MuffinByteLabs/stm32-industrial-io/references/reference-designs/README.md

# Manufacturer guidance and reference designs

I use manufacturer reference designs to study implementation details, then verify them against my exact device, package, load, and board geometry. The original documents retain their manufacturer attribution.

## Retained local reference

I retained the [TI LMR38020 evaluation-module guide](REF_TI_LMR38020QEVM_UserGuide_SNVU817.pdf) for my buck-family study. Its values and layout are examples; I will recalculate and review the implementation for this board. Primary source: [TI SNVU817](https://www.ti.com/lit/ug/snvu817/snvu817.pdf).

I retained [TI SLVAF10: Driving PWM Loads with TI High-Side Switches](REF_TI_PWM_HighSide_SLVAF10.pdf) for DO3 timing, load and thermal review. I keep its [source/hash record](pwm_reference.json) alongside the PDF. Primary source: [TI SLVAF10](https://www.ti.com/lit/pdf/slvaf10). Its example-device values do not replace TPS4H160B timing or measured qualification of my selected load.

## Guidance to consult during capture

- [STM32G474VE product documentation](https://www.st.com/en/microcontrollers-microprocessors/stm32g474ve.html): exact package datasheet, reference manual, errata, and hardware-development guidance.
- [STM32 system-memory boot guidance, AN2606](https://www.st.com/resource/en/application_note/an2606-stm32microcontroller-system-memory-boot-mode-stmicroelectronics.pdf): verify recovery interfaces and entry requirements for the exact device.
- Candidate-family [local datasheet index](../datasheets/README.md): regulator layout, analog protection orientation/thresholds, isolated-power constraints, and peripheral timing.

Before adopting a reference circuit, I will record its revision, applicable ordering code, differences from my conditions, recalculated values, and schematic/layout evidence. I will add evaluated circuits and fixture records as they become available.

My [architecture](../../docs/Architecture.md) integrates the STM32 directly on the PCB.
