MuffinByteLabs/stm32-industrial-io/references/market/README.md

# Archived Upwork research — October 4, 2026

The [portfolio research report](Upwork_PCB_Portfolio_Review_2026-10-04.pdf) records the original comparison against seven user-supplied search-page exports. It predates the final retained scope and October 6 circuit corrections. The active decisions are in [market alignment](../../docs/Market_Alignment.md) and [scope](../../docs/Scope.md); the old report is evidence of that research, not current drawing instructions.

The [compressed evidence archive](upwork_evidence_2026-10-04.zip) preserves the original 350 parsed cards, 347 deduplicated briefs, final topic counts and matching excerpts, manual exclusions, inventory summary/methodology and the original parsing/tagging methods. It also retains the qualitative research notes. Archived methods use neutral `source_inputs/` directories for the supplied exports and are historical source material, separate from the project's active maintenance tools.

| Saved artifact | SHA-256 |
| --- | --- |
| Research PDF | `683830c0acd94d14554fa28573698611e4c220752bb3f29f6e1f670abf690463` |
| Evidence ZIP | `4523380ecafd39a0a9c29b8d5da04f3d05c1d06b42af976b48a2e073a8041826` |

All ten original archive members were compared byte-for-byte with the source files before temporary outputs were removed. For public sharing, local computer paths were replaced with neutral source IDs in two inventories and the parser; job text, counts and matching evidence are unchanged. The original archive remains preserved locally outside this repository. Generated page/contact previews, repeated CSV/tagged copies, PDF-extracted text and one-use report-building helpers were discarded. The evidence does not establish current job availability or a random sample of the employment market.
