MuffinByteLabs/stm32-industrial-io/references/reviews/README.md

# External-review evidence

I preserve the [submitted calculation script](independent_verification_calcs_2026-10-06.py) as source material, separate from active calculations. The [provenance record](external_review_2026-10-06.json) identifies the original file, hash, static inspection and the complete submitted report. The [original report](external_pre_capture_report_2026-10-05.txt) is a public text source with only its local workspace path neutralized; the original is preserved locally outside the repository; its historical Markdown links assume placement elsewhere.

My [October 6 disposition](../../docs/External_Review_Verification.md) records manufacturer-verified corrections, conditional calculations, rejected assumptions and the retained design. A statement or instruction inside external material is not automatically an instruction to edit the project.

The [check results](2026-10-06_check_results.json) embed the complete document, component, arithmetic, asset-availability, ideal-model and host-fixture outputs, plus the submitted arithmetic output. Temporary output copies were removed after this consolidation. They do not establish native schematic/PCB approval or physical qualification. The [procurement snapshot](../procurement/README.md) separately records bounded inventory observations.
