MuffinByteLabs/stm32-industrial-io/docs/Pre_Schematic_Review.md

# Deep pre-schematic verification — October 4, 2026

**Historical review:** the October 6 [independent external-review disposition](External_Review_Verification.md) supersedes affected component codes, connections and asset counts below. It adds corrections missed here while retaining the feature set and unresolved physical gates. Use the current circuit specifications and component selections for capture.

**Disposition: retain every current feature and begin hierarchy/library preparation from the corrected capture package.** The specifications are a reviewed design baseline. The affected power/protection sheets still have capacitor and sequencing gates, and custom drawing assets require creation and exact-package comparison before wiring. This is not approval of a completed schematic, PCB, firmware or measured board rating.

I reviewed the folder as an integrated STM32G474VET6 controller: four isolated digital inputs, all four analog inputs, four diagnosed high-side channels including DO3 PWM, both relays, independently supplied isolated RS-485 and CAN/CAN FD, USB, EEPROM, debug and hardware permission. No selected feature was removed. The legacy ESP32S3 workspace name does not change the active MCU or native-project location.

## Corrections made in this review

Every confirmed finding below has **high confidence** from the cited manufacturer table or source inspection. Priority describes its effect before correction; the status describes the corrected documents/host source, not physical implementation.

| ID / priority | Finding, correction and evidence |
| --- | --- |
| PRE-01 / high | PA15/JTDI has a reset pullup. The previous 10 kΩ acquisition-enable pulldown could exceed the receiving gate's guaranteed-low voltage. I changed this specific pulldown to 1 kΩ ±1%, retained the other defaults and added its worst-case check. [STM32 DS12288 Table 12 footnote 5, p72, and Table 54, p128](../references/datasheets/STM32G474VE.pdf); [control pin/default instructions](circuits/Control_Service.md), [support arithmetic](calcs/support_checks.py). |
| PRE-02 / high | The selected SN74LVC2G04DCUR/VSSOP-8 ordering/package combination was unsupported. I selected the actual SN74LVC2G04DBVR/SOT-23-6, documented its physical pins and retained health inversion/unused-input grounding. [TI pin/package and orderable-device tables](../references/datasheets/SN74LVC2G04.pdf). |
| PRE-03 / high | The selected TPD2E2U06DBZR/SOT-23-3 combination was unsupported. I selected TPD2E2U06DCKR/SC70-3 and its IO1/IO2/GND map; both CC protection channels remain. [TI pin/package and orderable-device tables](../references/datasheets/TPD2E2U06.pdf). |
| PRE-04 / medium | STM32 USB drivers already include termination impedance. I retain both series footprints but initially fit 0 Ω; the former 22 Ω parts are optional DNP tuning candidates. The internal switchable D+ pullup is retained. [DS12288 Rev 6 Table 92](../references/datasheets/STM32G474VE.pdf). |
| PRE-05 / medium | The selected Samtec debug header is SMT, and its -K option does not establish an absent contact 7. I corrected mounting metadata and reserved/NC wording, with exact cable/key/land-pattern comparison still required. [Exact manufacturer code](https://www.samtec.com/products/ftsh-105-01-l-dv-k), [series assembly drawing](https://suddendocs.samtec.com/prints/ftsh-1xx-xx-xxx-dv-xxx-xxx-x-xx-mkt.pdf). |
| PRE-06 / medium | ADC supply decoupling minima were not tracked per pin. I added three open evidence records for the already-selected AVDD/DVDD capacitors. I added the recommended local 1 µF VDD bypass beside 100 nF at each TMUX7462F. I also corrected DVDD≤AVDD, three unused TMUX1511 channels, and LM4040's third-pin wording. [ADS8684A sections 6/10](../references/datasheets/ADS8684A.pdf), [TMUX7462F section 9.4](../references/datasheets/TMUX7462F.pdf), [TMUX1511](../references/datasheets/TMUX1511.pdf), [LM4040-N](../references/datasheets/LM4040-N.pdf). |
| PRE-07 / high | Host write echo/accepted sequence alone did not prove the expected control state. I strengthened confirmation to check identity/epoch, state, owner, health, live lease and complete applied outputs/PWM, with adversarial-response tests. [Host implementation](../tools/diagnostics/fieldio.py) and [tests](../tools/diagnostics/tests/test_diagnostics.py). |
| PRE-08 / high | Separate CAN boot identity and six measurement frames could permit a reset-mixed publication. The pending contract now requires matching opening/closing identities around the six exact ordered frames, a bounded receiver, FIFO streaming and stale-frame cancellation. [Protocol](../firmware/Protocol.md#classic-can-telemetry-v1--pending-after-modbus-bring-up); [RM0440 FDCAN message RAM/Tx handling](https://www.st.com/resource/en/reference_manual/rm0440-stm32g4-series-advanced-armbased-32bit-mcus-stmicroelectronics.pdf). |
| PRE-09 / high | Erasing a used EEPROM journal could reuse boot identity. The contract now requires output-inhibited technician provisioning/recovery and a trusted generation upper bound; unknown history stays inhibited. Its record/write/power-failure implementation remains pending. [Protocol boot freshness/storage](../firmware/Protocol.md). |
| PRE-10 / medium | Recovery wording sometimes placed commands before ARM. The consistent sequence is remove cause → DISARM/acknowledge → self-check/READY → fresh guards → ARM with zero commands → confirm ARMED → fresh SET. Enabled-mode CAN bus-off explicitly disarms/latches all six outputs under global-fault policy 1. [Interfaces](Interfaces.md), [validation](Validation.md#command-loss-and-rearm-demonstration), [protocol](../firmware/Protocol.md). |
| PRE-11 / medium | The budget used different eFuse tolerance assumptions and only nominal auxiliary voltage. I aligned the stated screening tolerance and added the 15.5 V/25 mA/60% corner: approximately 645.8 mW against a 650 mW branch reservation. I exposed that narrow margin and the complete converter-tree startup demand. [Power](circuits/Power.md), [budget](calcs/controller_budget.py). |
| PRE-12 / medium | CAD targets contained unregistered namespaces, descriptive placeholders and nonexistent stock IDs. I normalized exact identifiers, registered the initially empty IndustrialIO symbol collection, retained existing candidate footprints and added an availability audit/work list. Missing custom assets remain explicitly pending. [Library preflight](Library_Preflight.md), [availability audit](../scripts/audit_capture_readiness.py). |

## Open gates and their closure evidence

These are actual limits of the present evidence. I do not close them by lowering the targets or marking predicted results as measured.

| Gate / priority / confidence | Current evidence and required closure |
| --- | --- |
| CAP-01 / high / high | All 14 numeric-minimum supply/reference banks remain open in [capacitor_evidence.json](calcs/capacitor_evidence.json), alongside two separate isolated-port capacitance/startup gates and the parent hold-up temperature/time gate. Obtain exact-part bias/temperature data or documented measurement, account for tolerance and an explicit aging/lifetime basis, then recalculate any changed parts/quantities before freezing the affected rails. For each isolated converter, use TI's calculator with actual effective input/output capacitance, rail/load bounds and soft-start conditions; its allowed minima/maxima are still TBD and the calculator is not yet run. The chosen 5% ceramic aging allowance is an assumption. |
| SEQ-01 / high / high | VFP shutdown arithmetic is conditional on ≥500 µF effective parent capacitance, ≤1 ms complete child-disable delay, ≤25 mA parent discharge load and ≤5 µA total sourcing into each disabled child net. The 680 µF initial tolerance, nominal monitor delay and LDO input shutdown current do not prove those combined conditions. Close complete-net leakage/fault states, hold-up across the intended temperature/life basis, delay bounds, passive boost-feed startup and regulator soft-start/inrush analysis before approving the sequence. Capture rail/enable waveforms during bring-up. [Power](circuits/Power.md), [analog arithmetic](calcs/analog_checks.py). |
| LIB-01 / high / high | Missing custom assets affect 31 fitted-selection groups; the registered symbol library is empty. Create/review exact physical pins before wiring, exact land patterns before layout, and cable/connector/provenance checks before library release. Stock-asset presence is also not package approval. [Library preflight](Library_Preflight.md). |
| PWR-01 / medium / high | At VFIELD=8.4 V, assumed 80% buck efficiency and full four-channel load, the estimate is about 2.916 A against a 3 A continuous target, before remaining effects. The 15.5 V auxiliary allocation has about 4.2 mW branch reserve. Close hot path drop, true converter efficiency/loads, capacitor charging, regulator stability and thermal geometry; qualify the 9 V combined-load/enclosed fixture before claiming that envelope. [Budget](calcs/controller_budget.py), [power](circuits/Power.md). |
| ANA-01 / medium / high | Two-point calibration, ADC INL and loading equations do not complete the system error budget. Include reference/gain/offset drift, source impedance, shunts/protector behavior, filters/noise, calibration/reference uncertainty and simultaneous switching before approving the ±20 mV/±32 µA and wider temperature targets. Physical independent-point verification remains required. [Analog](circuits/Analog.md), [validation](Validation.md#analog-accuracy-and-timing). |
| NATIVE-01 / high / high | No native project/schematic/PCB exists. Capture physical pins, all support/default networks, reference islands and permission truth tables; reconcile generated MCU clocks/options/peripherals; run schematic review/ERC before layout, then four-layer review/parity/DRC before fabrication. [Capture package](Schematic_Capture.md), [KiCad workflow](../.github/workflows/kicad-ci.yml). |
| FW-01 / medium / high | Target application, nonblocking EEPROM records/journal, USB service, CAN peer/FD profile, timer mode transitions and commissioning builds are absent. The contracts now identify those implementation gates and applicable [ES0430 errata](https://www.st.com/resource/en/errata_sheet/es0430-stm32g471xx473xx474xx483xx484xx-device-errata-stmicroelectronics.pdf), including FDCAN EFBI disable/FIFO-only operation and SPI/USB handling. Host simulation cannot establish target behavior or qualification. [Firmware plan](../firmware/README.md), [protocol](../firmware/Protocol.md). |
| PHYS-01 / high / high | Actual fuse/FET/TVS energy, protection faults, rail removal, watchdog/reset/defaults, accuracy, PWM edges/sense windows, bus recovery, heat, enclosure fit and repeatability/soak are unmeasured. Complete the staged fixtures in [Validation](Validation.md), with actual build and instrument evidence. |

## Verification basis and checks

I checked all four selection files, all five circuit documents including loop status, MCU/resource/clock/default tables, interfaces, command/telemetry contracts, host source/tests, calculations, local library targets, reference metadata, workflows, mechanical/fabrication plans and document cross-links. Semiconductor pin/package conclusions use manufacturer documents; stock-library existence and repository audits have narrower scope.

My bounded ngspice DC run reproduced the independent equations: approximately 9.990234 V at the ADC for a 10 V input, 3.997871 V for a 20 mA sense input, and 0.648825 V at the MCU diagnostic ADC for the modeled 0.5 A output. Filter poles were approximately 143.8 Hz and 131.9 Hz. These are illustrative fixed-resistance, biased-input and finite-gain ideal-amplifier operating points; they do not simulate converter dynamics, IC fault recovery, stability, temperature or a whole board. [Model and check instructions](calcs/README.md).

The reproducible checks are the [repository audit](../scripts/audit_project.py), [selection scope audit](../scripts/audit_component_selections.py), [capture availability audit](../scripts/audit_capture_readiness.py), four [calculation scripts](calcs/README.md), [host tests](../tools/diagnostics/tests/test_diagnostics.py) and explicitly simulated CLI identity/snapshot examples. An asset report can pass its structural checks while reporting an open gate.

I also archived six [manufacturer capacitor characteristic exports](../references/capacitors/README.md) for the selected GRM31CR71E106KA12L. At 1 kHz/0.01 Vrms, its sampled typical capacitance over 0–50 °C is about 5.68–6.66 µF at 5.25 V and 6.17–7.55 µF at 3.4 V. These model curves support screening but do not establish production tolerance, aging or guaranteed minima; all capacitor gates remain open. No numeric curve result is substituted for the other selected parts.

| Check | Local review result and scope |
| --- | --- |
| Documents/references/paths | Passed local-link/anchor, 41 manifest PDF identity/hash, six capacitor CSV identity/hash/sample-summary and five project-relative asset-path checks; zero warnings/failures |
| Selection coverage | Passed for 162 component groups and 140 distinct ordering codes, including options/accessories; not released assembly quantities or stock approval |
| CAD asset availability | Valid identifiers and registered paths; all stock candidates checked in the installed KiCad 10 libraries. Assets remain missing in 31 of 148 fitted-selection groups; strict `--require-assets` rejects the unfinished library |
| Power/support/analog/PWM arithmetic | All four scripts pass their stated equations; PWM includes 1,620 analytical corners. The assumptions above remain open |
| Host behavior | 30 tests pass, including wrong accepted-control-state, reset/freshness, rejected-write, timeout/deadline, CRC/framing and calibration overflow cases |
| CLI development fixtures | Simulated identity and snapshot examples pass and remain explicitly synthetic |
| Analog DC/passive-pole simulation | Passes on ngspice 46; solver version, library hash and circuit hash are recorded by the script |
| Whitespace | No reported diff whitespace errors |
| Native and physical checks | Not run; reasons and stage requirements below |

I inspected the automated workflow definitions against [KiCad 10 CLI documentation](https://docs.kicad.org/10.0/en/cli/cli.html), the [official KiCad container tags](https://hub.docker.com/r/kicad/kicad/tags), and official GitHub action repositories. Missing native files are reported as ERC/DRC not run; hardware release tags require matching native files and exactly four copper layers. No remote CI run or release was performed by this local review.

## Checks not performed and why

| Check | Applicability/evidence limit |
| --- | --- |
| Schematic analyzer, native net tracing/ERC and schematic/PCB cross-check | Not run: `.kicad_sch`, `.kicad_pro` and `.kicad_pcb` absent |
| PCB full analysis/DRC, extracted-return-path/EMC and thermal/layout analysis | Not run: no placement, copper, stack-up or layout to analyze |
| Gerber/assembly review | Not run: no matching manufacturing exports or released BOM |
| Structured per-MPN datasheet extraction/cache coverage | No structured analyzer cache was generated; manual PDF/specification review and source identity/hash checks are the evidence |
| Full passive/IC/model/vendor simulation | Only the existing bounded DC model was applicable and run; no extracted native circuit or complete verified converter/protection model was available |
| Full lifecycle/inventory/BOM sourcing audit | Core manufacturer status was recorded in [Engineering review](Engineering_Review.md); this pass corrected exact codes/packages and did not obtain an exhaustive live distributor inventory or ordering approval |
| Target firmware/hardware/serial/USB/CAN/EEPROM interruption tests | Not run: no target application, assembled controller or physical fixture |

## Previous-review comparison and next action

I retained the earlier permanent-shunt loop protection, independent port supplies, low-line health network, all isolation boundaries, +15 V/VFP protection rails, all outputs and hardware gates. The new review corrections above supersede affected entries in the October 3/early October 4 [engineering review](Engineering_Review.md). The supplied architecture disposition now records retention rather than an undecided simplification.

I dismissed two apparent issues after checking evidence: GitHub `@v7` actions and the KiCad `10.0-full` container are real current upstream versions, and the old ESP32S3 folder name is only a workspace name. Neither justifies a feature or MCU change. A catalog lifecycle listing, a stock-symbol name, a passing arithmetic assertion or a green documentation job still does not establish electrical approval.

I start from [Library preflight](Library_Preflight.md), then follow [Schematic capture](Schematic_Capture.md). I resolve the affected capacitor/sequence/package gates before freezing those sheets, review the native circuit before layout, and keep every later milestone tied to measured evidence.
