MuffinByteLabs/stm32-industrial-io/references/datasheets/README.md

# Component references

I maintain manufacturer documents for my [circuit specifications](../../docs/Schematic_Capture.md). My [manifest](manifest.json) records PDF identity, hash and provenance; the documents do not by themselves approve circuit pins, layout or measured ratings.

| Selected family / code | Reference and scope |
| --- | --- |
| STM32G474VET6 | [STM32G474VE.pdf](STM32G474VE.pdf); [manufacturer](https://www.st.com/resource/en/datasheet/stm32g474ve.pdf); archival distributor-hosted PDF with manufacturer reference retained; capture implementation review pending |
| ADS8684A | [ADS8684A.pdf](ADS8684A.pdf); [manufacturer](https://www.ti.com/lit/ds/symlink/ads8684a.pdf); capture implementation review pending |
| TPS26632 | [TPS2663.pdf](TPS2663.pdf); [manufacturer](https://www.ti.com/lit/ds/symlink/tps2663.pdf); capture implementation review pending |
| LMR38020 | [LMR38020.pdf](LMR38020.pdf); [manufacturer](https://www.ti.com/lit/ds/symlink/lmr38020.pdf); capture implementation review pending |
| TPS62160 | [TPS62160.pdf](TPS62160.pdf); [manufacturer](https://www.ti.com/lit/ds/symlink/tps62160.pdf); capture implementation review pending |
| ISO1212 | [ISO1212.pdf](ISO1212.pdf); [manufacturer](https://www.ti.com/lit/ds/symlink/iso1212.pdf); capture implementation review pending |
| TMUX7462F | [TMUX7462F.pdf](TMUX7462F.pdf); [manufacturer](https://www.ti.com/lit/ds/symlink/tmux7462f.pdf); capture implementation review pending |
| TPS4H160B-Q1 | [TPS4H160-Q1.pdf](TPS4H160-Q1.pdf); [manufacturer](https://www.ti.com/lit/ds/symlink/tps4h160-q1.pdf); capture implementation review pending |
| ISO1410 | [ISO1410.pdf](ISO1410.pdf); [manufacturer](https://www.ti.com/lit/ds/symlink/iso1410.pdf); capture implementation review pending |
| ISO1042 | [ISO1042.pdf](ISO1042.pdf); [manufacturer](https://www.ti.com/lit/ds/symlink/iso1042.pdf); capture implementation review pending |
| TPS3431 | [TPS3431.pdf](TPS3431.pdf); [manufacturer](https://www.ti.com/lit/ds/symlink/tps3431.pdf); capture implementation review pending |
| G5Q-1-DC5 | [G5Q.pdf](G5Q.pdf); [manufacturer](https://components.omron.com/sites/default/files/datasheet_pdf/J155-E1.pdf); archival distributor-hosted PDF with manufacturer reference retained; capture implementation review pending |
| 24LC64 | [24LC64.pdf](24LC64.pdf); [manufacturer](https://ww1.microchip.com/downloads/aemDocuments/documents/MPD/ProductDocuments/DataSheets/24AA64-24FC64-24LC64-64-Kbit-I2C-Serial-EEPROM-DS20001189.pdf); capture implementation review pending |
| SMCJ33CA | [SMCJ.pdf](SMCJ.pdf); [manufacturer](https://www.littelfuse.com/assetdocs/littelfuse_tvs_diode_smcj_datasheet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); archival distributor-hosted PDF with manufacturer reference retained; capture implementation review pending |
| TPS3808 | [TPS3808.pdf](TPS3808.pdf); [manufacturer](https://www.ti.com/lit/ds/symlink/tps3808.pdf); capture implementation review pending |
| SN74LVC2G125 | [SN74LVC2G125.pdf](SN74LVC2G125.pdf); [manufacturer](https://www.ti.com/lit/ds/symlink/sn74lvc2g125.pdf); capture implementation review pending |
| SN74LVC2G08 | [SN74LVC2G08.pdf](SN74LVC2G08.pdf); [manufacturer](https://www.ti.com/lit/ds/symlink/sn74lvc2g08.pdf); capture implementation review pending |
| SN74LVC1G74 | [SN74LVC1G74.pdf](SN74LVC1G74.pdf); [manufacturer](https://www.ti.com/lit/ds/symlink/sn74lvc1g74.pdf); capture implementation review pending |
| TMUX1511 | [TMUX1511.pdf](TMUX1511.pdf); [manufacturer](https://www.ti.com/lit/ds/symlink/tmux1511.pdf); capture implementation review pending |
| TPS3702 | [TPS3702.pdf](TPS3702.pdf); [manufacturer](https://www.ti.com/lit/ds/symlink/tps3702.pdf); capture implementation review pending |
| TPS3700 | [TPS3700.pdf](TPS3700.pdf); [manufacturer](https://www.ti.com/lit/ds/symlink/tps3700.pdf); capture implementation review pending |
| CSD19537Q3 | [CSD19537Q3.pdf](CSD19537Q3.pdf); [manufacturer](https://www.ti.com/lit/ds/symlink/csd19537q3.pdf); capture implementation review pending |
| TPS26611DDFR | [TPS2661.pdf](TPS2661.pdf); [manufacturer](https://www.ti.com/lit/ds/symlink/tps2661.pdf); capture implementation review pending |
| UCC33421QDHARQ1 | [UCC33421-Q1.pdf](UCC33421-Q1.pdf); [manufacturer](https://www.ti.com/lit/ds/symlink/ucc33421-q1.pdf); capture implementation review pending |
| SN74LVC2G17DBVR | [SN74LVC2G17.pdf](SN74LVC2G17.pdf); [manufacturer](https://www.ti.com/lit/ds/symlink/sn74lvc2g17.pdf); capture implementation review pending |
| BSS138P,215 | [BSS138P.pdf](BSS138P.pdf); [manufacturer](https://assets.nexperia.com/documents/data-sheet/BSS138P.pdf); capture implementation review pending |
| TPS61040DBVR | [TPS61040.pdf](TPS61040.pdf); [manufacturer](https://www.ti.com/lit/ds/symlink/tps61040.pdf); capture implementation review pending |
| SN74LVC2G04DBVR | [SN74LVC2G04.pdf](SN74LVC2G04.pdf); [manufacturer](https://www.ti.com/lit/ds/symlink/sn74lvc2g04.pdf); capture implementation review pending |
| TPD2E2U06DCKR | [TPD2E2U06.pdf](TPD2E2U06.pdf); [manufacturer](https://www.ti.com/lit/ds/symlink/tpd2e2u06.pdf); capture implementation review pending |
| SiT8008BI-22-XXS-8.000000E | [SiT8008.pdf](SiT8008.pdf); [manufacturer](https://www.sitime.com/datasheet/SiT8008); capture implementation review pending |
| TPS7A1601DGNR | [TPS7A16.pdf](TPS7A16.pdf); [manufacturer](https://www.ti.com/lit/ds/symlink/tps7a16.pdf); capture implementation review pending |
| OPA2320AIDR | [OPA320.pdf](OPA320.pdf); [manufacturer](https://www.ti.com/lit/ds/symlink/opa320.pdf); capture implementation review pending |
| MMBT3904,215 | [MMBT3904.pdf](MMBT3904.pdf); [manufacturer](https://assets.nexperia.com/documents/data-sheet/MMBT3904.pdf); capture implementation review pending |
| PMV30UN2R | [PMV30UN2.pdf](PMV30UN2.pdf); [manufacturer](https://assets.nexperia.com/documents/data-sheet/PMV30UN2.pdf); capture implementation review pending |
| SMBJ8.5CA-E3/52 | [SMBJ.pdf](SMBJ.pdf); [manufacturer](https://www.vishay.com/docs/88392/smbj.pdf); capture implementation review pending |
| PESD2CANFD24V-T | [PESD2CANFD24V-T.pdf](PESD2CANFD24V-T.pdf); [manufacturer](https://assets.nexperia.com/documents/data-sheet/PESD2CANFD24V-T.pdf); capture implementation review pending |
| TPS70933DBVR | [TPS709.pdf](TPS709.pdf); [manufacturer](https://www.ti.com/lit/ds/symlink/tps709.pdf); capture implementation review pending |
| SN74AUP1T17DCKR | [SN74AUP1T17.pdf](SN74AUP1T17.pdf); [manufacturer](https://www.ti.com/lit/ds/symlink/sn74aup1t17.pdf); capture implementation review pending |
| LM4040AIM3-2.5/NOPB | [LM4040-N.pdf](LM4040-N.pdf); [manufacturer](https://www.ti.com/lit/ds/symlink/lm4040-n.pdf); capture implementation review pending |
| BAS70-04,215 | [BAS70-04.pdf](BAS70-04.pdf); [manufacturer](https://assets.nexperia.com/documents/data-sheet/BAS70-04.pdf); capture implementation review pending |
| PMEG4010CEJ,115 | [PMEG4010CEJ.pdf](PMEG4010CEJ.pdf); [manufacturer](https://assets.nexperia.com/documents/data-sheet/PMEG4010CEJ.pdf); capture implementation review pending |

I retain references for the active circuit selections. PDF identity and revision provenance remain separate from exact-package and circuit approval.
