MuffinByteLabs/stm32-industrial-io/docs/External_Review_Verification.md

# Independent disposition of the external review — October 6, 2026

**The review identified real documentation and selection defects. I corrected the buffer outputs, fitted power connector, reset supervisor/oscillator selection and digital-regulator package. I also adopted a conditional power-good startup sequence, reserved digital-input protection sites and reduced custom connector work using exact stock candidates. Every selected board feature remains.**

The suggested wider 5 V health window and protection deletions are not approved replacements. The current design still needs the capacitor, power sequencing, library, sourcing, native implementation and measured qualification work described below. This record supersedes affected component values and readiness counts in the [October 4 review](Pre_Schematic_Review.md); that review remains the historical record of its own changes. The earlier review missed the buffer map, power-connector allocation and reset release mismatch.

## Evidence and scope

I read the full supplied [external report](../references/reviews/external_pre_capture_report_2026-10-05.txt), reviewed its calculation source before execution, reran its arithmetic, inspected the active specifications and selections, compared the challenged circuits with manufacturer tables and checked installed KiCad assets. The original [calculation script](../references/reviews/independent_verification_calcs_2026-10-06.py) is preserved byte-for-byte; its [provenance](../references/reviews/external_review_2026-10-06.json) identifies both the downloaded script and archived original report. The public text source neutralizes only the local workspace path; original bytes are preserved locally outside the repository, and historical relative links assume a different location; active drawing instructions are in this project's [capture package](Schematic_Capture.md).

The script uses only arithmetic, `math`, `json` and standard output. Static inspection found no filesystem writes, process execution or network operations before it was run. Reproducing a calculation does not establish the assumptions behind it. It remains reference material, separate from the active project calculations.

**High confidence** below means a manufacturer pin/package/table, installed asset or directly inspected project fact establishes the conclusion. **Conditional** means the arithmetic is reproducible but depends on explicitly unverified leakage, converter, thermal or physical assumptions. No native schematic/PCB exists yet; ERC, DRC, layout EMC, extracted thermal analysis and whole-board fault simulation are unavailable at this stage. No assembled-board rating or standards compliance is established.

## B1–B5: the five headline findings

| Finding | Verified disposition and changes |
| --- | --- |
| B1: SN74LVC2G125 output map | **Accepted, high confidence.** DCU pins are 1=1OE_N, 2=1A, **3=2Y**, 4=GND, 5=2A, **6=1Y**, 7=2OE_N, 8=VCC. I corrected [Control and service](circuits/Control_Service.md), [loop status](circuits/Loop_Status.md) and both component records. LOOP1 uses pin 6 to PD8; LOOP2 uses pin 3 to PD9. The installed `74xGxx:74LVC2G125` symbol already has the correct map. These corrections cover nine crossing-buffer packages and one loop qualifier; no captured circuit existed to rewire. [TI Rev Q p4](https://www.ti.com/lit/ds/symlink/sn74lvc2g125.pdf). |
| B2: main power connector absent from fitted allocations | **Accepted, high confidence.** I added one 1759017 header and one off-board 1757019 mating plug to [power selections](components/power.json). Pin 1 is VIN_RAW and pin 2 MAIN_GND. The existing field catalog entries remain quantity zero, avoiding double counting. Both manufacturer pages identify the mating pair; physical coding and footprint approval remain open. [Header](https://www.phoenixcontact.com/en-us/products/pcb-header-mstb-25-2-g-508-1759017), [plug](https://www.phoenixcontact.com/en-us/products/pcb-plug-mstb-25-2-st-508-1757019). |
| B3: reset release above worst-case digital rail | **Accepted.** Three supervisors become TPS3808G30DBVR; the oscillator becomes SiT8008BI-22-XXS-8.000000E, with a 2.25–3.63 V supply option. The retained divider gives 3.296080 V nominal. Including resistor temperature drift, the conservative PSM rail screen is 3.160441–3.448874 V. G33 maximum release is 3.193951 V, leaving −33.510 mV. G30 maximum release is 2.902646 V, leaving +257.795 mV at the digital rail and +304.354 mV against the TPS709 rail's 3.207 V lower bound. These are DC screens, not ripple/startup guarantees. [TPS3808](https://www.ti.com/lit/ds/symlink/tps3808.pdf), [TPS62160](https://www.ti.com/lit/ds/symlink/tps62160.pdf), [SiT8008](https://www.sitime.com/datasheet/SiT8008). |
| B4: ADC5_OK margin and proposed second ±9% monitor | **Concern accepted; proposed fix deferred.** I retained the existing strict ADC monitor in FIELD5V_VALID, ANALOG_VALID and actuator permission. Using a second ±9% monitor in place of strict ADC hardware qualification would permit operation outside the ADC's 4.75–5.25 V specified AVDD range. Its 4.509050 V minimum undervoltage trip also leaves insufficient allowance for the isolated-power input bead: an illustrative worst-load screen gives 4.490547 V at UCC input, below its 4.5 V recommended minimum. Wider limits are not a substitute for qualifying the supply. Actual ripple, load steps and monitor reentry must be measured. [ADS8684A](https://www.ti.com/lit/ds/symlink/ads8684a.pdf), [TPS3702](https://www.ti.com/lit/ds/symlink/tps3702.pdf), [UCC33421-Q1](https://www.ti.com/lit/ds/symlink/ucc33421-q1.pdf). |
| B5: five chips have no authorized stock | **Blanket conclusion rejected; bounded sourcing concerns retained.** On October 6 direct DigiKey pages showed TPS4H160=5,799 and ISO1212=11,539 pieces. Selected ISO1410/ISO1042 reel codes showed zero, but same-device/same-package tube codes ISO1410DW and ISO1042DWV showed 34 and 90. MCU sources checked showed zero; UCC33421 was available to order rather than held in stock, with a displayed 26-week/1,000-piece reel condition. I recorded carrier alternatives without silently changing the selected BOM. The MCU and isolated-power modules need a practical authorized procurement route before package freeze. These observations prove neither worldwide availability nor worldwide absence. [Dated evidence and sources](../references/procurement/README.md). |

The TPS62160 feedback-current maximum of 400 nA is tested at FB=1.2 V, whereas regulation uses about 0.8 V. The signed allowance used by the rail screen is deliberately conservative; it is not a guaranteed bidirectional limit at the operating point. Line, load and ripple effects still need closure. TPS3808 hysteresis is 1% typical and 2.5% maximum; the release screen includes that maximum plus threshold tolerance.

STM32's full specified USB behavior requires 3.0–3.6 V. G30 reset release is not a precise 3.0 V USB undervoltage detector. I added independent digital-rail collapse, USB detach/recovery and incomplete-calibration-write tests to [service instructions](circuits/Control_Service.md), [firmware requirements](../firmware/README.md) and [validation](Validation.md). The normal digital-rail screen exceeds 3.0 V, but brownout operation is still a qualification gate. [STM32 DS12288 Table 92](../references/datasheets/STM32G474VE.pdf).

### The 5 V window is tighter than the external trip-only calculation suggests

The updated [support calculation](calcs/support_checks.py) includes resistor drift, ADC load, the AVDD filter and maximum TPS3702 hysteresis. For the strict window, worst-case reentry bounds are 4.881600 V and 5.111600 V. The main rail's reference/divider DC screen including resistor drift is 4.912216–5.088216 V; ADC AVDD can be 4.900083 V after the series resistor. The resulting DC reentry margins are only **18.483 mV and 23.384 mV**. Against the broader 4.90–5.10 V design target, the corresponding margins are **6.268 mV and 11.600 mV** after filter allowance.

I do not label this margin acceptable without a load-step/ripple budget. Capture must preserve an explicit gate for normal startup/recovery, relay switching, both isolated converters, acquisition load and the complete commanded-output fixture. If it fails, revise regulation/filtering/monitor allocation as a coordinated change while preserving the hardware permission and ADC validity contracts.

## S1–S10: capture and layout suggestions

| Suggestion | Verified disposition |
| --- | --- |
| S1: digital-input TVS | **Adopted as four DNP protection provisions, not a qualified populated design.** The 100 Ω fast input needs a protection assessment. TI's small-RTHR example connects the shunt from **SENSE, after RTHR, to DI_COM**, rather than blindly placing it on IN. I reserved one site per channel and recorded SMBJ33CA-E3/52 as an unapproved candidate. Its 33 V standoff and 53.3 V stated pulse clamp do not alone prove margin for board parasitics or the intended surge; capacitance, 20 kHz timing and pulse/negative-fault behavior need qualification. Bare-IC ±60 V capability is not a terminal rating. [ISO1212 Rev G pp24–26, Figure 8-10](https://www.ti.com/lit/ds/symlink/iso1212.pdf), [Vishay SMBJ](https://www.vishay.com/docs/88392/smbj.pdf). |
| S2: eFuse PGOOD enables field buck | **Adopted with additional conditions.** PGOOD requires both PGTH qualification and internal FET enhancement. The existing VIN-tied enable was manufacturer-allowed; delaying converter startup is an improvement. I selected 475 kΩ/100 kΩ PGTH, a 100 kΩ pullup to VFIELD and a 100 kΩ EN pulldown. Pulling up from downstream 3.3 V would prevent startup. EN_FIELD_BUCK is not MCU-connected. Drift/leakage-aware PGTH rise/fall screens are 6.672741–7.128292 V and 6.179566–6.701648 V. With an unverified ±1 µA EN-current allowance, EN-high is ≥3.245512 V at minimum PG release and EN-low ≤0.045990 V at 35 V. EN≤VIN+0.3 V during rapid collapse and complete leakage states remain open; the datasheet's 5 nA is typical, not a maximum. [TPS2663 §8.3.2/§9.2.2.5.1](https://www.ti.com/lit/ds/symlink/tps2663.pdf), [LMR38020](https://www.ti.com/lit/ds/symlink/lmr38020.pdf), [power instructions](circuits/Power.md). |
| S3: passive charging of 680 µF boost bank | **Accepted as an existing startup gate.** The inductor/diode path exists even while boost switching is disabled. Capacitor-only energy or C×dV/dt is not a complete converter-tree/FET SOA proof. A resistor or NTC needs its own cold/hot startup, voltage-drop, dissipation and restart assessment; I did not add an arbitrary value or delete the protection branch. SEQ-01 remains open. |
| S4: functional earth and bonding | **No automatic bonds added.** I reserved an optional isolated CHASSIS_FE location in [mechanical requirements](../mechanical/README.md), pending enclosure/cable/EMC design. A 1 MΩ path from each island to common FE intentionally connects those islands at DC; 4.7 nF per island is not justified by TI's example, which calls for effective DI ground coupling to other grounds/PE ≤500 pF. A low-voltage board in an insulated enclosure does not automatically require the proposed network. No protective-earth function is claimed. |
| S5: connector cross-mating | **Accepted as a physical capture/mechanical requirement.** Labels, colors and ordinary polarization do not prevent a wrong socket. All 13 terminal harness destinations, including the four identical analog pairs, need a documented compatible coding scheme and tests for wrong or partially inserted plugs. Position counts distinguish the main power pair from relay/output connectors, but identical positions still need coding. Exact coding articles/patterns remain pending. |
| S6: thermal plan | **Accepted as a qualification requirement, not a predicted enclosure rating.** The approximate 5.8 W estimate is useful for a fixture but rests on conversion/diode/load assumptions. Manufacturer JEDEC θJA does not establish actual board temperature, nor is 100 mm² per diode a universal minimum. Thermal paths, exposed-pad vias, copper, simultaneous loads and the 0–50 °C enclosed fixture remain required. |
| S7: copper widths | **Screening guidance only.** Legacy IPC-2221 equations do not produce universal IPC-2152 minimum widths. Actual copper thickness, planes, narrow sections, vias, allowable rise and thermal surroundings control the result. I did not turn the approximate table or its blanket 0.5 oz prohibition into board rules. |
| S8: library/reference housekeeping | **Accepted selectively.** Stale inverter, CC-protector and oscillator README entries are corrected. Exact MC1844210/1844223/1844236 stock candidates match article/family, 3.5 mm pitch, 1.2 mm drills and body dimensions. I use them while pin 1/mating/enclosure approval stays open. Selected MSTB1759017/1759020/1759033 have no exact installed match; MSTBA or flanged MSTB-GF is not interchangeable by pitch alone. I kept unused local footprints and explicitly marked them unselected. The 41 checked IC PDFs do not cover every passive/package drawing; missing exact drawings and structured extraction coverage remain library tasks. [Library preflight](Library_Preflight.md), [reference index](../references/datasheets/README.md). |
| S9: switch CAN clock to 80 MHz | **Deferred.** The existing 144 MHz core/48 MHz USB/FDCAN plan remains. At BRP=1, 500 kbit/s and 2 Mbit/s correspond to 96 and 24 quanta; this does not yet specify sample point, SJW or transmitter delay compensation. The external report does not establish that a 48 MHz kernel is defective. The proposed HSI48/CRS USB path adds another clock-validation obligation. Target timing and peer/cable qualification remain required. |
| S10: minor operating details | **Accepted as limits where supported.** I added the G5Q low-current contact limitation: its 10 mA/5 V P-level datum is a reference at the stated switching condition, not a universal guaranteed minimum. Tiny dry-circuit loads need a suitable signal relay or a measured contract. The existing RS-485 fixture already states −7..+7 V common mode and a reference conductor. I retained 100 kHz I²C, visibility qualification at the selected LED current, the existing ≥50 ms acquisition-invalid interval and explicit latch-off recovery. A typical 15 ms reference startup at 22 µF does not prove a linear or worst-case 44 µF settling time. IMON remains a test point: direct field-powered telemetry to an unpowered MCU would need a protected receiving path. |

I accepted the additional assembly change **TPS62160DSGR → TPS62160DGKR**. DGK is leaded VSSOP-8 with the same eight signal pins and **no exposed pad/pin 9**. The stock symbol is `Regulator_Switching:TPS62160DGK`; its MSOP-8 footprint is a drawing-comparison candidate. DGK's datasheet θJA=184.3 °C/W is higher than DSG's 61.8 °C/W. Assigning the whole 0.75 W branch at 80% efficiency gives an illustrative 0.1875 W loss/34.56 °C rise/84.56 °C junction at 50 °C ambient. This screen is not enclosure/PCB thermal approval. I did not also change the eFuse to TPS26633: that changes package and overload/pulse behavior and needs a separate review. [TPS62160 package/thermal tables](https://www.ti.com/lit/ds/symlink/tps62160.pdf).

## R1–R5: proposed component deletions

| Proposal | Why it is not adopted in this baseline |
| --- | --- |
| R1: combine digital and field logic rails | A plausible architecture alternative, but two same-ground rails can still start, collapse or fail differently. Common ancestry does not make their powered-off crossings unnecessary. A real merger needs loading, noise, supervision and failure-scope review; removing buffers while retaining separate rails is not the proposal. It does not address the independent positive protection-rail sequence. |
| R2: delete TMUX7462F, +15 V and VFP rails | ADS8684A permits ±20 V input stress under stated AVDD conditions, including a <30 kΩ AVDD-to-ground path; the retained 10 kΩ bleeder is relevant. This makes an alternative worth studying, but does not prove continuous ±30 V terminal miswires, transient clamps or complete power-off impedances. Removing the switches also removes independent input-fault indications and requires replacement data-validity/recovery behavior. I did not claim identical protection or retire SEQ-01 from paper arithmetic. [ADS8684A p5/absolute-maximum note](https://www.ti.com/lit/ds/symlink/ads8684a.pdf). |
| R3: delete the buffered, referenced and switched current-diagnostic path | **Rejected as presented.** Current limited to a fraction of a milliamp can still charge an unpowered rail unless a guaranteed sink exists. TPS709 reverse protection is not a sink. The suggested clamp current is not proof of MCU pin safety or absence of backpower; the existing TMUX1511 power-off protection remains. The proposed chain reads about 1.350 V at 0.5 A versus 0.6488 V now, approximately **2.081×**, so “−1.7% gain change” describes only the CS burden effect, not total conversion gain. ADC range, fault separation and calibration would need redesign. No assertion is made that the calculated external diode current alone proves an internal MCU injection-limit violation. |
| R4: ISOW1412/ISOW1044 integrated isolated power | Possible alternatives, not drop-ins. ISOW1412 is full duplex and needs explicit Y→A/Z→B wiring for a half-duplex port; its bus absolute range is −12/+15 V. The current bidirectional protection's stated −14.4 V clamp cannot transfer unchanged. ISOW1044 changes receiver common-mode range from ±30 to ±12 V and bus-fault rating from ±70 to ±58 V. Both devices still need bulk/bypass capacitance, ferrites and specified layout; two separate secondary islands can remain independent, but capacitor/startup/EMC gates are not eliminated. [ISOW1412](https://www.ti.com/lit/ds/symlink/isow1412.pdf), [ISOW1044](https://www.ti.com/lit/ds/symlink/isow1044.pdf), [ISO1042](https://www.ti.com/lit/ds/symlink/iso1042.pdf). |
| R5: tie health outputs to one wired-AND | Replaces distinct reset, supply-enable and actuator-permission scopes with a new circuit, while losing separate fault visibility. The described combination omits the watchdog-disabled state represented by ENOUT. Adding ENOUT to the existing watchdog WDO→supervisor MR path could instead create startup reset lock. All open-drain/supply/current states and the entire truth table must be redesigned. The retained asynchronous ARM clearing, all six output gates and fresh ARM after recovery remain. |

These proposals may preserve headline connector counts while changing protection, supervision or diagnosis. Consequently, the external claim of deleting 25–37 active parts “without dropping any feature” is not verified. No replacement design, netlist or fault qualification was supplied to establish it.

## Calculation and standards claims that were not adopted

- The external script's `tick_us` field calculates a frequency in MHz, not a tick period. Both happen to equal 1 at the selected 1 MHz timer. Period is `1e6 / (144e6 / 144)` microseconds.
- ADS8684A drift figures used by the script are maximum-table entries, but an RSS total still assumes an independence/statistical model. Calibration-source accuracy, temperature behavior, TVS leakage change and shunt heating assumptions are not measured guarantees. The existing calibrated accuracy targets stay open.
- The script's buck-bank shorthand uses three 22 µF parts where the selected field buck has four. Its bottom-up service and startup estimates do not supersede the 6 W ceiling, 5.75 W reservations or complete converter-tree charging gate. There is no basis for “everything else has margin”: low-line input power, the positive auxiliary reservation and 5 V reentry remain narrow.
- `spice_dc_check.py --library` identifies the **ngspice solver DLL**, not a collection of vendor IC models. The project's bounded ideal DC testbench can run with the installed DLL; it does not simulate real IC faults or startup.
- Murata CSVs are typical manufacturer characteristic/model exports, not measured-board curves or guaranteed minimum capacitance. All 14 numeric banks, two isolated-port gates and the parent hold-up evidence remain open.
- Nominal DI thresholds and output voltage-drop arithmetic do not establish IEC 61131-2 compliance. TVS presence does not establish ESD/EFT/surge immunity, and ≤30 V nominal operation alone does not establish a SELV system or a particular safety classification. The existing finite DC fixtures and isolation targets remain separate from certification claims. No mandatory clock or fabrication rule is inferred from an unsourced standards summary.

The attached instructions to commit/tag, delete files and create the native project were treated as review recommendations, not user requests. The original review/source files remain preserved locally; public copies omit local computer paths and record the changed hashes; this pass changed the engineering package and its verification evidence. I did not commit, tag, remove assets, create a schematic, order parts or reserve inventory.

## Verification results and next gates

The [dated check record](../references/reviews/2026-10-06_check_results.json) records passing document/selection/asset structural audits, four active arithmetic checks, bounded ideal DC simulation with ngspice 46, 30 passing host tests and simulated identity/snapshot checks. The document audit covers 43 Markdown files, 438 local links, 41 PDF identities/hashes and six capacitor CSV identities/hashes/samples. The selection audit covers 166 groups and 142 unique order codes. The availability audit checks 150 fitted board groups, finds 30 groups with missing assets and no unchecked installed stock assets, and reports **the asset gate open**. Structural success does not close LIB-01; no native project files exist yet.

The practical capture order remains [the staged implementation plan](Implementation_Plan.md). Begin hierarchy and exact-package library preparation; keep MCU/UCC procurement, capacitor minima, 5 V reentry/load steps, complete eFuse/buck/boost startup, positive protection-rail shutdown, brownout USB, connector coding and physical thermal/fault tests explicit before freezing affected sheets. Native connectivity/ERC precedes layout, and PCB/DRC and measured firmware/board qualification precede release. None of those gates is closed by the external review or by passing host tests.
