MuffinByteLabs/stm32-industrial-io/CHANGELOG.md

# Changelog

## Rev A — In development

### October 6, 2026

- I prepared the complete updated repository for publication under MuffinByteLabs, preserved byte-hashed source evidence against Git line-ending conversion, and neutralized local computer paths in public research records while retaining original sources locally.

- I removed generated previews, cached text, temporary scripts, duplicate research/check outputs and three unselected footprint copies. Research evidence is compressed under references/market, full verification outputs are consolidated in the dated check record, and the original external report was preserved before public-copy path neutralization. Website mockups were moved outside the hardware project; active design files, referenced models, licenses and pending capture work remain.

- I independently checked the supplied external review and preserved its calculation source/provenance, with a disposition for each headline finding, capture suggestion and simplification.
- I corrected all ten LVC2G125 package output maps, fitted the main power connector/mate allocation, selected G30 reset supervisors and the XX oscillator supply option, and changed the digital regulator to leaded TPS62160DGKR with thermal and drawing gates retained.
- I added conditional eFuse PGOOD-to-field-buck sequencing, a drift/leakage-aware PGTH/EN screen and stricter ADC trip/reentry arithmetic. Strict ADC health and the existing powered-off protection/diagnostic circuits remain.
- I reserved four unpopulated DI protection sites, clarified connector coding/optional chassis requirements and relay low-current limitations, and replaced three MC-family footprint targets with exact installed stock candidates.
- I recorded a fresh bounded key-IC inventory snapshot; MCU and isolated-power sourcing remain gates, while available transceiver carrier alternatives need procurement confirmation. No feature was removed and no physical rating or completed native design was approved.

### October 4, 2026

- I retained the complete architecture and every selected feature after a deep pre-schematic review, with a current review record and library-first capture instructions.
- I corrected PA15's reset pulldown, USB series-link fitting, the inverter and CC-protector ordering codes/packages, and debugger-header metadata without changing their functions.
- I added the recommended TMUX supply bypasses and missing per-pin ADC capacitor evidence, and made hold-up, complete-net sourcing, disable delay, whole-tree startup and worst-case power assumptions explicit.
- I normalized and registered local CAD targets, added a missing-asset audit, strengthened host command confirmation, and clarified CAN coherence, boot-journal recovery and zero-command ARM before SET. Native hardware, target firmware and measured qualification remain pending.

- I froze the major controller functions after reviewing the supplied freelance-job sample and recorded where the scope matches recurring design/bring-up needs.
- I added M0–M4 implementation milestones: capture gates, nominal-supply static Modbus control, classic CAN, bounded PWM and full operating/fault/CAN FD qualification.
- I added an explicit rail/crossing architecture review before affected circuitry is frozen; current component selections and protection obligations remain the baseline.
- I made the protocol, diagnostic/calibration workflow, cohesive application demonstration and traceable portfolio evidence explicit deliverables. Development host simulations remain separate from physical qualification.
- I added an initial Modbus diagnostic CLI with read-only snapshots/raw capture, timestamped CSV logs, offline calibration fitting and explicit guarded actuator commands; its protocol fixtures run in the project checks. Target firmware and physical serial tests remain pending.

- I revised Rev A around external board power and self-powered USB data service.
- I removed the analog voltage-command stage, its dedicated bias/reference circuits and USB source-transfer circuitry from the active design.
- I retained precision inputs, both isolated buses, power supervision, relays and current diagnostics.
- I added DO3 timer PWM with a bounded 100 Hz load/timing target, phase-aware current sensing and explicit shutdown/rearming behavior.
- I separated receiving-domain buffer enables, added global driver-fault ARM clearing and coordinated low-line rail monitoring with the post-protection power margin.
- I updated circuit specifications, component selections, references, calculations and qualification requirements together. Native schematic/PCB implementation and measured ratings remain pending.

### October 3, 2026

- I completed circuit capture specifications and exact component/support-value selections for power, control/service, analog and field I/O.
- I matched the auxiliary boost to light-load operation, completed rail-health and domain-crossing details, and added bounded AO manufacturer-model checks.
- I fixed connector pairs/pin orders, finite load/cable fixtures and the 5.75 W service allocation.
- I added explicit pre-capture capacitor evidence and library gates, including a bank-by-bank report of unresolved capacitance minima.

- I reviewed production component status and documented a conflict-free provisional MCU allocation.
- I revised current-loop protection to preserve the permanent shunt load, added protected AO terminal feedback, and selected larger independent isolated bus supplies.
- I updated the service-power budget, hardware arming/reset design, input-fault conditions, and schematic/qualification checks.
- I added a reproducible ideal DC frontend simulation with explicit model limits.

### October 2, 2026

- I defined a four-layer STM32 controller architecture with protected DC power, analog sensing, diagnosed load outputs, and separately isolated communication buses.
- I documented the electrical interfaces, fault behavior, circuit tradeoffs, and validation targets.
- I added reproducible power and measurement calculations, a manufacturer-reference manifest, and automated document and library checks.
- I organized the hardware, firmware, mechanical, and manufacturing documentation around the same electrical contract.

I have not released a hardware revision. I’ll record each release here with its matching design sources, firmware version, manufacturing package, and measured validation results.
