MuffinByteLabs/stm32-industrial-io/(commit log)

2026-09-07 docs: Rev A specification review, design document and repo skeleton
    Board 2 (ESP32-S3 Protected Field I/O Controller) starts as Board 1 did: with
    the design written down and reviewed before capture. The frozen plan v7.3 §4
    spec was re-derived number by number (docs/calcs/board2_calcs.py); the review
    (docs/reviews/Spec_Review_RevA_2026-09-07.md) found four blocking issues and
    the design document resolves them.
    - docs/ESP32S3_FieldIO_Final_Design_Document.md: full per-sheet design
    - docs/reviews: spec review with findings table and confirmed numbers
    - docs: PROJECT_STATUS, PinMap, Hard Rules, KiCad settings (moat DRC rule),
    Assembly & stencil plan, BringUp guide, LCSC cart draft
    - hardware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
    [ESP32S3_FieldIO_RevA_LCSC_Cart_Draft.csv]
2026-09-07 docs: second-opinion review weighed; adopt SOT-223 LDO, 47k/1uF input filter, 1:21 VIN_SENSE, open VLOAD jumper, silk USB rule
    Nine of the second review's fifteen points adopted, six declined with
    arithmetic (docs/reviews/Second_Opinion_Review_RevA_2026-09-07.md).
    Design document, pin map, bring-up guide, rules, settings, cart draft and
    calc script updated together; first review annotated, not rewritten.
    [ESP32S3_FieldIO_RevA_LCSC_Cart_Draft.csv]
2026-09-07 docs: industry-standard audit; Hongfa relays, MMBT2222A, IEC 61131-2 Type 1 inputs, Degson terminals, fiducials, DIN enclosure, MSL/IPC-A-610, changelog, CI
    Every part checked for lifecycle, grade, temperature rating and sourcing; the
    design checked against IEC 61131-2, IPC-2221/7351/6012/A-610, J-STD-020/033;
    the repository against engineering-organisation expectations
    (docs/reviews/Industry_Standard_Audit_RevA_2026-09-07.md). Four commodity
    parts upgraded in the same footprints, six process items added, nine items
    recorded as optional / Rev B. CHANGELOG.md, mechanical/ and a kicad-cli
    ERC/DRC workflow added.
    [ESP32S3_FieldIO_RevA_LCSC_Cart_Draft.csv]
2026-09-07 docs: firmware contract — input filter value corrected to 47 kΩ + 1 µF
2026-09-14 parts: final pre-capture picks - optos EL817S1(C)(TU)-FV C470884 (VDE; -F stockless), MMBT2222ALT1G C82460, Phoenix MKDS 1,5 terminal family (Degson same-footprint alt), Bourns MF-RX110, Lite-On LTST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
    [ESP32S3_FieldIO_RevA_LCSC_Cart_Draft.csv]
2026-10-03 Plan STM32 industrial I/O controller and configure GitHub project
    [ESP32S3_FieldIO_RevA_LCSC_Cart_Draft.csv]
2026-10-03 Enable encrypted PDF audits and current GitHub Actions runtimes
2026-10-03 Document my STM32 controller as a client-facing engineering project
2026-10-03 Specify Rev A circuits and document remaining capture gates
2026-10-04 Refine Rev A scope and add guarded PWM load control
2026-10-06 Prepare verified Rev A capture package and diagnostics
    [GRM31CR71E106KA12_bias_0C_0p01Vrms.csv, GRM31CR71E106KA12_bias_25C_0p01Vrms.csv, GRM31CR71E106KA12_bias_25C_1Vrms.csv, GRM31CR71E106KA12_bias_50C_0p01Vrms.csv, GRM31CR71E106KA12_temp_3p4V_0p01Vrms.csv, GRM31CR71E106KA12_temp_5p25V_0p01Vrms.csv]
